seonghapark/cuav/Documents/README.md

## Documents Info

```
Documents - 2019-12-19 ver.
├ Rail
│ ├ ball_screw_connector.stl
│ ├ radar_antenna_half1.stl
│ ├ radar_antenna_half2.stl
│ ├ radar_board_half1.stl
│ ├ radar_board_half2.stl
│ ├ rail_motor_side.stl
│ └ rail_opposite_motor_side.stl
├ GUAVA.pdf
├ Log_Convention.pdf
├ Message_Definition.pdf
├ ROS_Design.pdf
└ ROS_Tutorial.pdf
```
* **Rail**: 3D printing models for making rail
* **GUAVA**: This is final project presentation file that contains progress and future work
* **Log_Convention**: ROS log convention for our system (kor ver.)
* **Message_Definition**: ROS message definition for our system (kor ver.)
* **ROS_Design**: ROS design for our system (kor ver.)
* **ROS_Tutorial**: tutorial for learning ROS (kor ver.)
