seonghapark/cuav/daily_log/Inbae_Kang.md

Inbae Kang
=============
강인배 팀원의 일지입니다.

## 2019-09-05

1. An Approach for Reducing Computational Time for Real-Time Autonomous Vehicle Tracking 논문 읽고 팀원들과 내용 공유.

## 2019-09-06

1. try to build and execute ROS_system in fall2019 branch with README.md. But I get hard with Installation because I use Windows subsystem Ubuntu. when I use command of runros I faced an error related in gnome-terminal.
2. So I install ubuntu in my computer and I am retrying installation and I will do to tomorrow.

## 2019-09-09

1. I get an same error that ros cannot find the script files even after I installed Ubuntu in my computer.

2. therefore I reinstall ubuntu and project files and I install and execute successfully.

- Executed Screen
executed screen

## 2019-09-10

1. Read Paper "Combination of Radar and Audio Sensors for Identification of Rotor-type Unmanned Aerial Vehicles (UAVs)"

## 2019-09-11

1. 회의를 통해서 역할 분담. ROS part 배정

2. 회의 내용을 바탕으로 전체적인 그림 정리.

- System Architecture
System Architecture

- ROS
ROS

3. ROS Tutorial 진행을 위해 Ubuntu 16.04 LTS 버전 설치 준비.

## 2019-09-12

1. 오전 중에 치과에 다녀옴.

2. ROS Tutorial을 진행하기 위해서, Ubuntu 16.04 LTS 버전을 랩탑에 설치

3. ROS 환경 구축 및 ROS 설치

## 2019-09-13

1. ROS Tutorial 진행.

2. Tutorial 진행하며 [내용 정리](https://github.com/cleverdevk/ROS_Tutorial)

## 2019-09-16

1. ROS Tutorial 진행.

2. Tutorial 진행하며 [내용 정리](https://github.com/cleverdevk/ROS_Tutorial)

## 2019-09-17

1. ROS Tutorial 진행.

2. Tutorial 진행하며 [내용 정리](https://github.com/cleverdevk/ROS_Tutorial)

## 2019-09-18

1. ROS Tutorial 진행.

2. Tutorial 진행하며 [내용 정리](https://github.com/cleverdevk/ROS_Tutorial)

## 2019-09-19

1. ROS Tutorial 진행.

2. Tutorial 진행하며 [내용 정리](https://github.com/cleverdevk/ROS_Tutorial)

3. [ROS Design Documnet](https://www.notion.so/cleverdevk/ROS-Design-9cbf88796d634cb692d4113f3f8526bd) 작성

## 2019-09-20

1. [ROS Design Documnet](https://www.notion.so/cleverdevk/ROS-Design-9cbf88796d634cb692d4113f3f8526bd) 작성

## 2019-09-23

1. [ROS Design Documnet](https://www.notion.so/cleverdevk/ROS-Design-9cbf88796d634cb692d4113f3f8526bd) 작성 및 github에 업로드

2. 새로운 GUAVA 디렉토리에 ROS Workspace 생성 및 패키지 생성

## 2019-09-24

1. ROSPY Tutorial 진행

2. Main Pacakge의 Decision 노드 작성

3. git conflict 문제 발생.

## 2019-09-25

1. ROSPY Tutorial 진행

2. Main Pacakge의 Decision 노드 작성

## 2019-09-26

1. ROSPY Tutorial 진행

2. Main Pacakge의 Decision 노드 수정

3. Raspberry Pi에 설치 중

## 2019-09-30

1. ROS Design 문서 수정.

2. Message Definition 문서 작성.

3. decision node에서 사용하는 message 파일 생성 및 빌드

## 2019-10-01

1. ROS Design 문서 수정.

2. Message Definition 문서 수정.

3. Camera Pacakage 기본 code 작성.

## 2019-10-02

1. Storage node 코드 작성

## 2019-10-15

1. raspberry pi kinetic에서 python3 사용하도록 설정

2. raspberry pi와 main pc 사이에 ROS 상에서 통신

## 2019-10-16

1. 각 device에서 통신을 위한 기본 설정 스크립트 작성

2. ROS Design 문서 업데이트

## 2019-10-21

1. ROS Design Camera 부분 topic 업데이트

2. Log Convention 작성

3. 수정된 node에 따라서 decision 노드 코드 

## 2019-10-22

1. main package nodes logging code 작성

2. Log Convention 수정

3. project introduction ppt 작성 중

## 2019-10-23

1. Rail node 코드 작성

2. project introduction ppt 작성 중

## 2019-10-24

1. project instruction ppt

2. Raspberry PI에 ROS 설치된 Ubuntu 설치
* * *
