seonghapark/cuav/daily_log/Haeeun_Lee.md

# Daily log of Haeeun Lee
---
# September
### 2019.09.05
1. 논문을 읽고 팀원들과 내용 공유
	- CNN_radar

### 2019.09.06
1. raw_data 디렉토리의 1_read_data.py 실행
	- rabbitMQ 대시보드까지 확인했으나 바이너리 파일 변환 결과는 확인 못함.
2. ros 설치 시도	
	- mac OS에 설치 시도
	- ubuntn vm에 설치 시도

### 2019.09.09
1. vmware Fusion에 ubuntu 18.04, ROS melodic 설치 후 실행
2. ROS 공부

### 2019.09.10
1. radar_audio 논문 읽기
2. 코드 분석

### 2019.09.11
1. vmware Fusion에 ubuntu 16.04, ROS kinetice으로 다시 설치
2. 코드 분석

### 2019.09.12
1. make_sar_image.py 실행
2. make_sar_image.py 코드 분석
3. SAR, FMCW 등 개념 조사

### 2019.09.13
1. 회의를 통해 앞으로 해야 할 일들에 대한 정리
2. make_sar_image.py 코드 분석 및 사용된 라이브러리 공부 
3. 안테나 확인

### 2019.09.16
1. 레이더 연결 후 코드 실행 확인
2. matplotlib 라이브러리 관련하여 코드를 실행하면 컴퓨터가 꺼지는 오류가 발생해서 찾아보았지만 아직 해결하지 못함

### 2019.09.17
1. 어제 발생했던 오류 해결
2. ROS 튜토리얼로 기본 통신 구조 확인
3. 참고할 코드 및 수정해야 할 코드 확인하고 이전 프로젝트 모델 분석 및 디렉토리 수정
4. 모델 구조 작성

### 2019.09.18
1. radar 패키지 및 raw 메시지 생성
2. ros 패키지 생성 및 커스텀 메시지 생성하는 법 md로 정리
3. msg import 되지 않는 문제 해결 필요

### 2019.09.19
1. raw 데이터 생성해서 ros로 publish 하는 코드 작성 (0_r_get_data.py 수정)

### 2019.09.20
1. 0_get_data.py 코드 수정 후 실행되는 것 확인

### 2019.09.23
1. ros 관련 코드 python3 사용하도록 변경
2. 수정된 코드에 따라 ros 패키지 구조 변경 중 
3. make_sar_image.py python3로 수정 중

### 2019.09.24
1. make_sar_impage.py python3로 수정
2. 변경된 패키지 구조 및 메시지에 맞게 0_get_data.py 수정
3. git conflict 해결해야 함

### 2019.09.25
1. 레이더 필드 테스트

### 2019.09.26
1. analyzer.py, make_sar_image.py 코드 분석
2. binary 데이터 분석

### 2019.09.27
1. draw.py ROS로 변경
2. 레이더 관련해서 차고음님께 연락드려서 미팅 일정 잡음 (29일 오전)

### 2019.09.30
1. draw.py 코드 변경하기 위해 분석
2. 레이더 실행되는 것 확인

---
# October
### 2019.10.01
1. draw.py ros로 변경 중
2. 레이더 외부에서 실험
	- 탐지 가능 거리
	- 레이더 높이

### 2019.10.02
1. draw.py 관련 Thread 공부

### 2019.10.04
1. README 작성

### 2019.10.10
1. draw.py 수정
2. radar.sh 작성

### 2019.10.15
1. draw.py에서 pcolormesh 오류 확인하기 위해 레이더 필요
2. 레이더 받아서 실시간 결과 확인 제외하고 ros 연결되고 이미지 나오는 부분까지 실험할 예정

### 2019.10.16
1. 레이더 패키지 통합

### 2019.10.17
1. 실내에서 레이더 실험 진행
	- get_data.py부터 make_sar_img.py까지 쉘로 실행
	- 철판을 들고 움직여봤는데 결과가 제대로 나오는 것인지는 확인 불가

### 2019.10.22
1. 로그 남기도록 코드 수정
2. sar-reference 논문 공부

### 2019.10.23
1. sar-reference 논문 공부

### 2019.10.24
1. sar-reference 논문 공부
2. 파동과 관련된 개념 공부

### 2019.10.28
1. ROS 구조 관련 회의

### 2019.10.29
1. RNN, LSTM 공부
2. `UrbanSound8K` 데이터로 예제 실습
	- tensorflow를 사용한 코드로 실행했지만 오류 발생

### 2019.10.30
1. 변경된 ROS 구조로 코드 수정
	- 원래 회의애서 정한대로 수정 중 오류를 발견하고 구조 변경 필요
	- 임시로 토픽 만들어서 analyzer까지 연동되는 것 확인

---
# November
### 2019.11.4
1. 레일에 레이더 올려서 실험 진행
	- ROS publish 지연 문제 발견
	- 1초 4/7인치 기준으로 코드 수정하니 런타임 에러 발생
2. 메인컴퓨터와 접속 시도
	- 현재 맥북에서 VM으로 실행하고 있어서 같은 네트워크가 아니라 접속 불가
	- 라즈베리 파이로 포팅 필요

### 2019.11.5
1. realtime으로 plotting 하도록 코드 수정 중
2. 레이더 보드 합쳐서 실험 진행
	- 나사로 인한 간섭 확인
	- 가끔씩 튀는 경우가 있는데 차후에 외부에서도 실험해봐야 할 것 같음
3. VM network bridge로 바꿔서 접속 시도
	- ROS master node에는 접속이 되지만 localhost가 아닌 ROS URI를 사용하면 각 노드에서 subscribe를 하지 못함
	- 라즈베리파이 포팅 필요. 내일 포팅할 예정
	
### 2019.11.6
1. 라즈베리 파이 포팅 후 master node와 통신되는 것 확인
2. realtime plotting 코드 수정 위해 분석
