seonghapark/cuav/GUAVA/catkin_ws/src/camera/20191113_202102_image.jpg

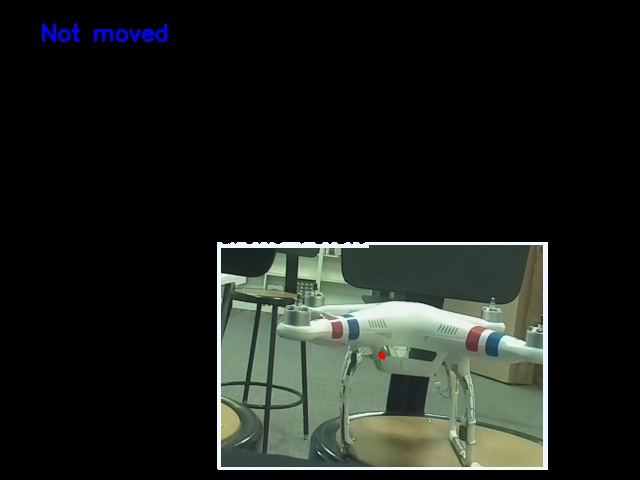
GUAVA/catkin_ws/src/camera/20191113_202102_image.jpg
