seonghapark/cuav/GUAVA/catkin_ws/src/camera/20191118_211927_image.jpg

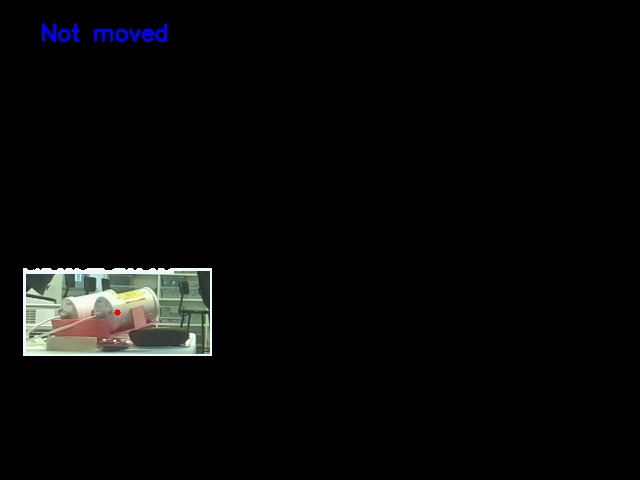
GUAVA/catkin_ws/src/camera/20191118_211927_image.jpg
