seonghapark/cuav/GUAVA/catkin_ws/src/main/storage/camera_image/20191119_164044_image.jpg

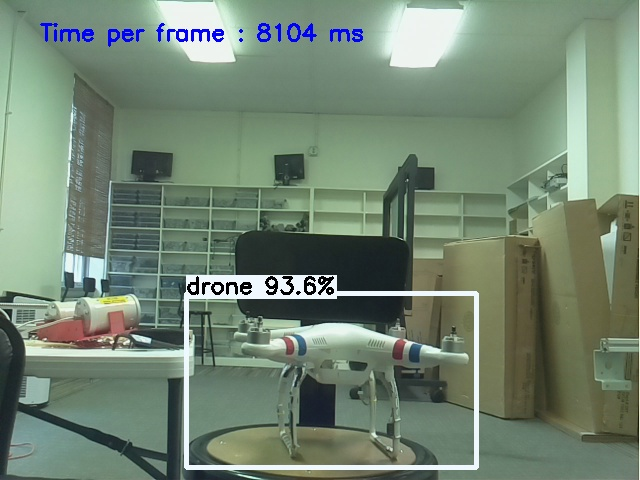
GUAVA/catkin_ws/src/main/storage/camera_image/20191119_164044_image.jpg
