seonghapark/cuav/GUAVA/catkin_ws/src/main/storage/camera_image/20191120_191302_image.jpg

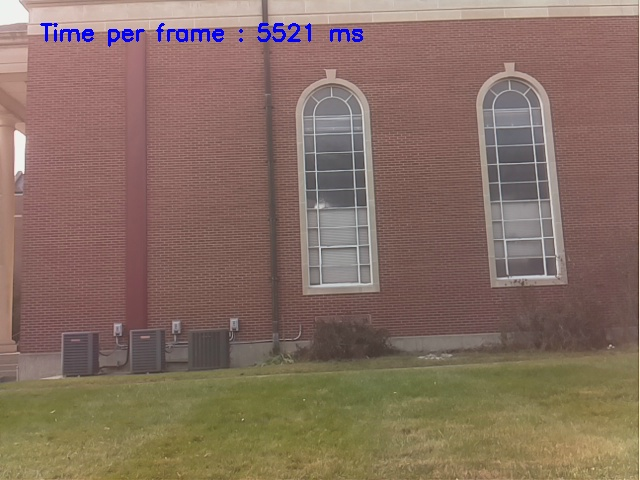
GUAVA/catkin_ws/src/main/storage/camera_image/20191120_191302_image.jpg
