seonghapark/cuav/GUAVA/catkin_ws/src/main/storage/camera_image/20191120_191727_image.jpg

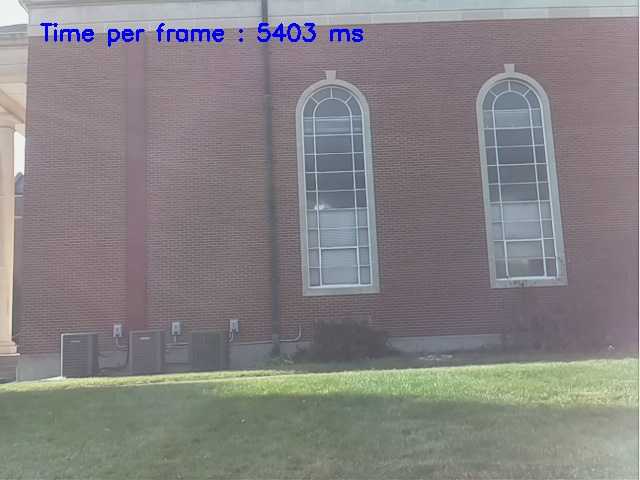
GUAVA/catkin_ws/src/main/storage/camera_image/20191120_191727_image.jpg
