seonghapark/cuav/GUAVA/catkin_ws/src/main/storage/camera_image/20191121_182903_image.jpg

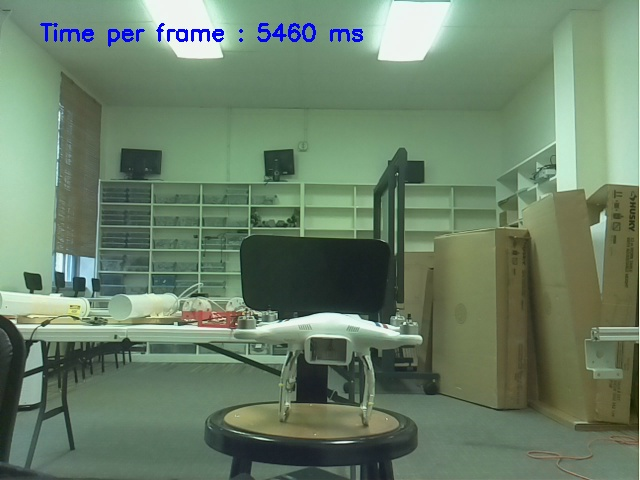
GUAVA/catkin_ws/src/main/storage/camera_image/20191121_182903_image.jpg
