seonghapark/cuav/references/radar_sar_rma/sar_image.png

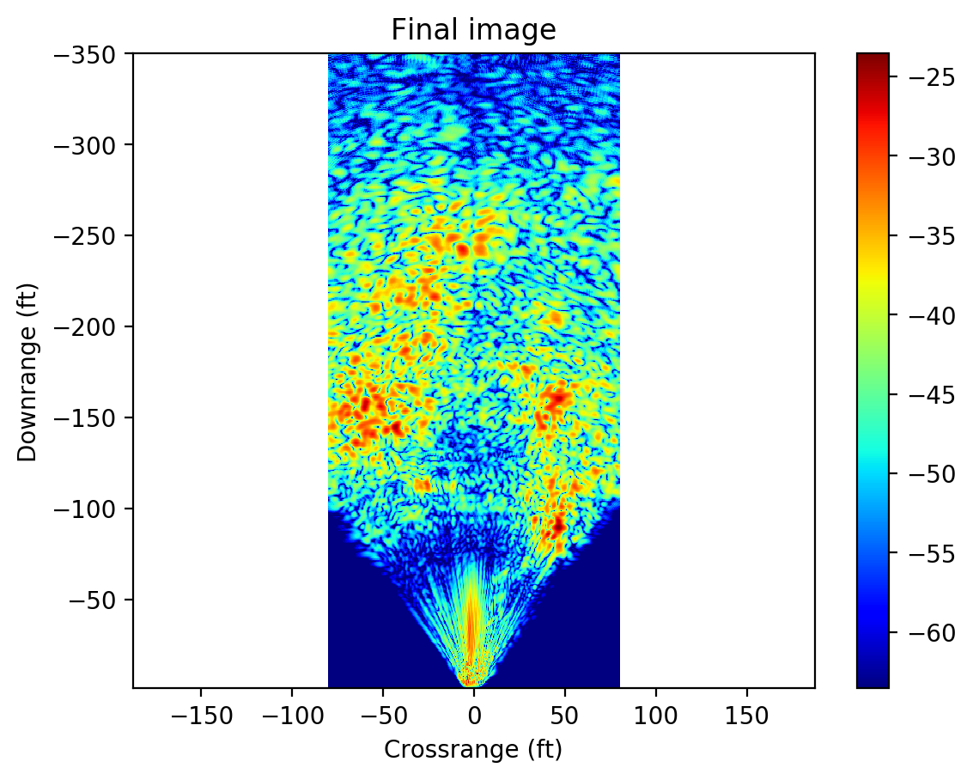
references/radar_sar_rma/sar_image.png
