seonghapark/cuav/Documents/Rail/radar_antenna_half2.stl

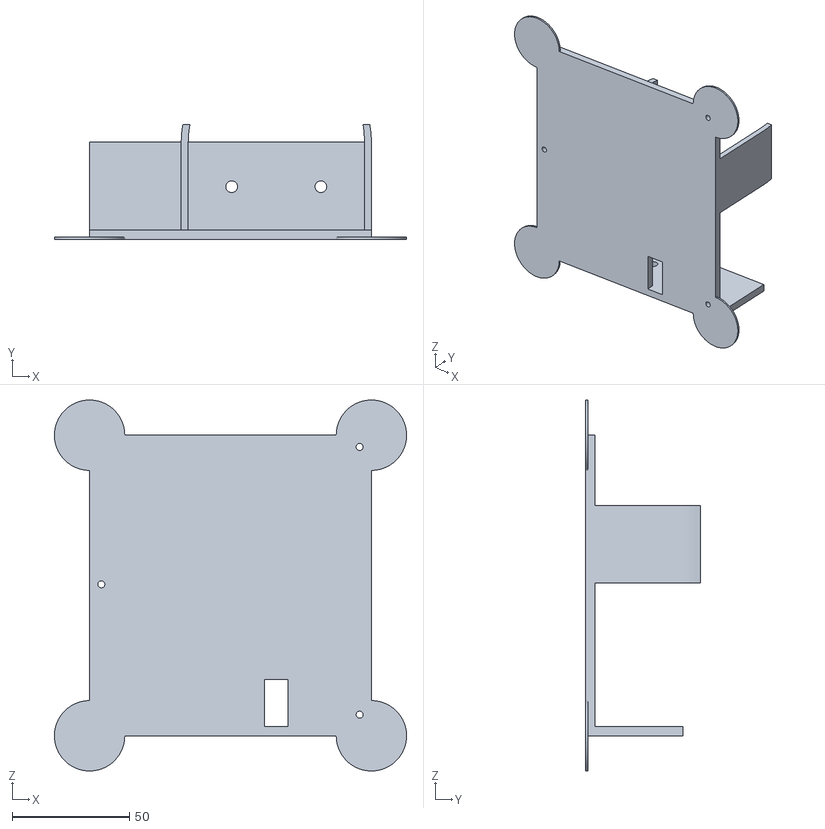
[picture p43: CAD file, 2019-12-20]
Documents/Rail/radar_antenna_half2.stl
150.0 x 49.0 x 158.0
