seonghapark/cuav/Documents/Rail/rail_motor_side.stl

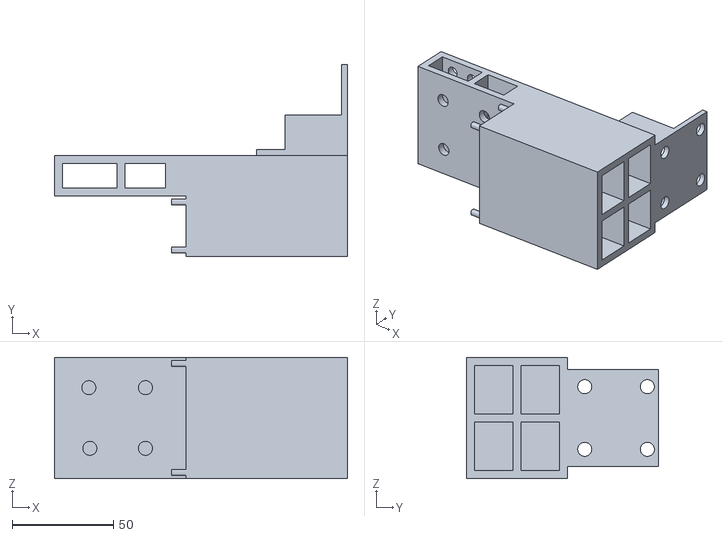
[picture p44: CAD file, 2019-12-20]
Documents/Rail/rail_motor_side.stl
145.0 x 95.0 x 60.0
