seonghapark/cuav/Documents/Rail/rail_opposite_motor_side.stl

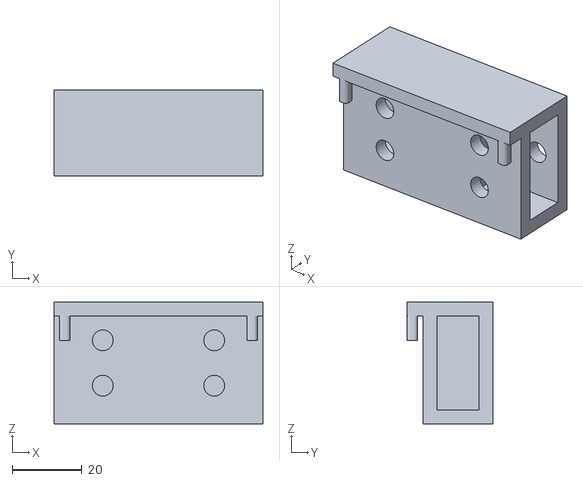
[picture p45: CAD file, 2019-12-20]
Documents/Rail/rail_opposite_motor_side.stl
60.0 x 24.6 x 35.0
