seonghapark/cuav/Documents/Rail/radar_board_half2.stl

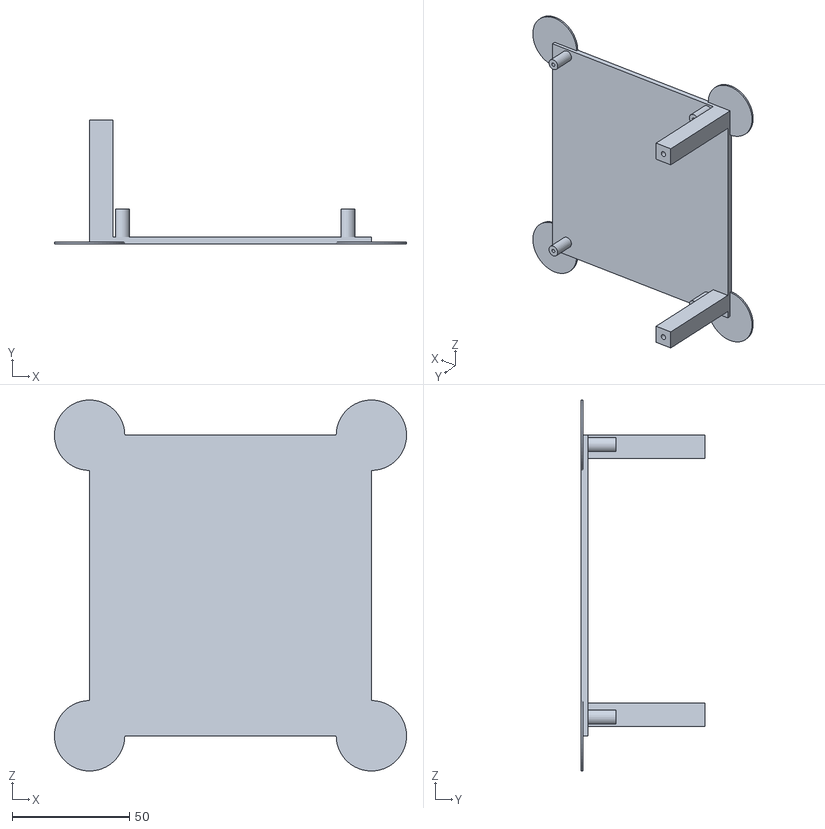
[picture p46: CAD file, 2019-12-20]
Documents/Rail/radar_board_half2.stl
150.0 x 53.0 x 158.0
