seonghapark/cuav/Documents/Rail/ball_screw_connector.stl

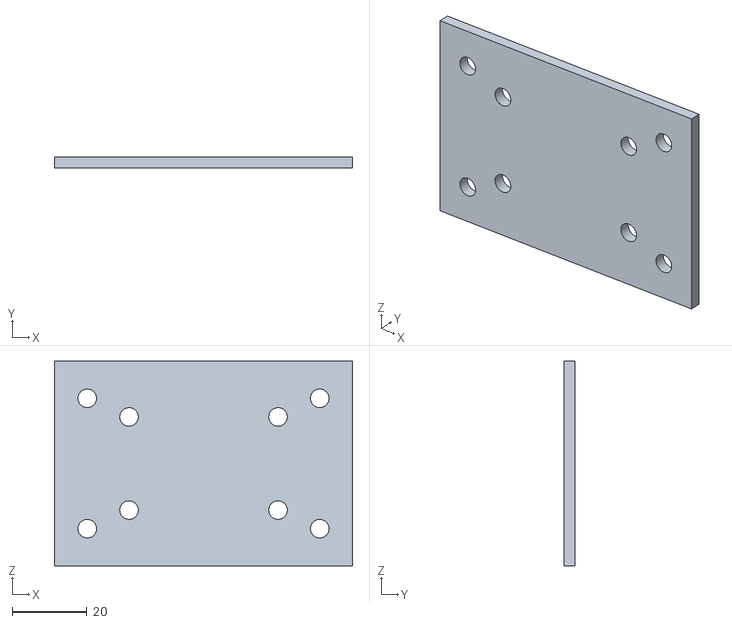
[picture p47: CAD file, 2019-12-20]
Documents/Rail/ball_screw_connector.stl
80.0 x 3.00 x 55.0
