seonghapark/cuav/(list of files, cad)

Other CAD files:
Documents/Rail/radar_antenna_half1.stl
