seonghapark/cuav/(commit log)

2019-09-11 ros kinetic 설치로 변경
2019-09-11 ros readme 수정
    참고 : https://m.blog.naver.com/opusk/220984001237
2019-09-11 Update daily_log: KKN(190911)
    2019년 9월 11일 수요일 일지 업데이트
2019-09-13 colormap 수정
2019-09-13 colormesh 옵션 수정
2019-09-13 Update daily_log: KKN(190913)
    2019년 9월 13일 일지 업데이트
2019-09-16 realtime으로 radar data 가져와서 sar image를 만들기 위한 폴더
2019-09-16 Update daily_log: KKN(190916)
    2019년 9월 16일 월요일 일지 작성
2019-09-17 binary_converter.py 추가
2019-09-17 Update daily_log: KKN(190917)
    2019년 9월 17일 화요일 일지 작성
2019-09-18 Update daily_log: KKN(190918)
    2019년 9월 18일 수요일 일지
2019-09-19 add rail msg
2019-09-19 Update daily_log: KKN(190919)
    2019년 9월 19일 목요일 일지
2019-09-20 fake rail node
2019-09-21 Update daily_log: KKN(190920)
    2019년 9월 20일 금요일 일지 업데이트
2019-09-23 add sample rate field to wav.msg
2019-09-23 Update daily_log: KKN(190923)
    2019년 9월 23일 월요일 일지 업데이트
2019-09-24 패키지 구조에 맞게 0_get_data.py 수정
2019-09-24 Update daily_log: KKN(190924)
    2019년 9월 24일 화요일 일지 업데이트
2019-09-25 Update daily_log: KKN(190925)
    2019년 9월 25일 수요일 일지 업데이트
2019-09-26 threading in decision.py
2019-09-27 Update daily_log: KKN(190927)
    2019년 9월 27일 금요일 일지 업데이트
2019-09-30 Update daily_log: KKN(190930)
    2019년 9월 30일 월요일 일지
2019-10-01 add camera node ROS source
2019-10-01 Update daily_log: KKN(191001)
    2019년 10월 1일 화요일 일지
2019-10-02 Update daily_log: KKN(191002)
    2019년 10월 2일 수요일 일지
2019-10-10 camera detection code
    [yolov3-drone.cfg, yolov3-tiny-drone.cfg]
2019-10-11 Update daily_log: KKN(191011)
    2019년 10월 11일 금요일 일지 업데이트
2019-10-15 camera codes move
    [yolov3-drone.cfg, yolov3-tiny-drone.cfg]
2019-10-16 Update daily_log: KKN(191015)
    2019년 10월 15일 화요일 일지 업데이트
2019-10-16 debugging print code added
2019-10-16 Update daily_log: KKN(191016)
    2019년 10월 16일 수요일 일지 업데이트
2019-10-16 detect objects in frame until railstop
2019-10-18 Update daily_log: KKN(191017)
    2019년 10월 17일 목요일 일지 업데이트
2019-10-22 yolo-tiny-drone cfg config change
    [yolo-drone.cfg]
2019-10-23 add rail ROS code
2019-10-24 detect.py fix
    [yolo-drone.cfg, yolov3-drone.cfg]
2019-10-24 Update daily_log: KKN(191024)
    2019년 10월 24일 목요일 일지 업데이트
2019-10-28 Update daily_log: KKN(191028)
    2019년 10월 28일 월요일 일지 업데이트
2019-10-30 make rail package ,modify decision node, add Log node
2019-10-30 fake start-rail CAMERA
2019-10-30 send frame to ROS nodes
2019-10-30 Change Image's location(SAR, Camera)
2019-10-30 Change directory of rail code
2019-10-31 yolo tiny weight for test
    [yolov3-tiny.cfg]
2019-11-11 print debugging info
2019-11-11 add source for camera data
2019-11-12 Update daily_log: KKN(191111)
    2019년 11월 11일 월요일 일지 업데이트
2019-11-12 modify camera msgs
2019-11-12 code to covert frame -> jpg file
2019-11-12 get direction + frames of detected objects
2019-11-12 add debugging code for summary camera
2019-11-12 fix end rail not detected
2019-11-12 debug code classifier camera
2019-11-13 add gloabal flag to control rail start-end
2019-11-13 add new publisher fake-rail
2019-11-13 remove print debugging code
2019-11-13 readme about python files in camera package
2019-11-14 web threading success
2019-11-18 remove error - classifier camera (img not numpy)
2019-11-18 change sample rate in realtime
2019-11-18 sample rate correction
2019-11-19 change sample rates for make sar
2019-11-19 modify variable name about camera image
2019-11-19 change mod
    [yolo-drone.cfg, yolov3-tiny-drone.cfg, yolov3-tiny.cfg]
2019-11-20 remove socket io
2019-11-21 remove web-socket
2019-11-22 checking samples per ramp up time
